schwallsunk/Geiger_Mueller_Handheld/Hardware/CAD/top_case_geiger_counter_slider.step

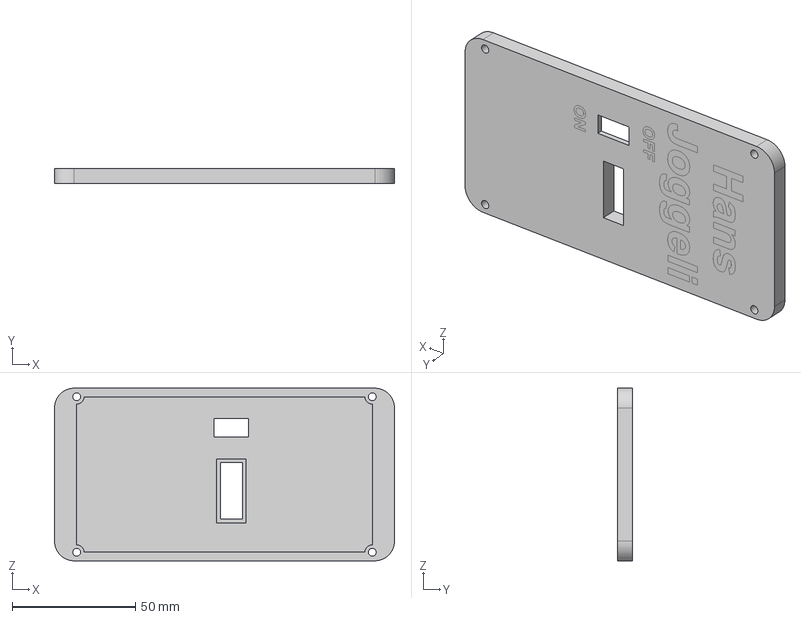
[picture p1: CAD file, 2026-09-18]
Hardware/CAD/top_case_geiger_counter_slider.step
138.0 x 6.00 x 70.1 mm
