schwallsunk/Geiger_Mueller_Handheld/Hardware/EDA/Geiger_counter_LoRaWAN.step

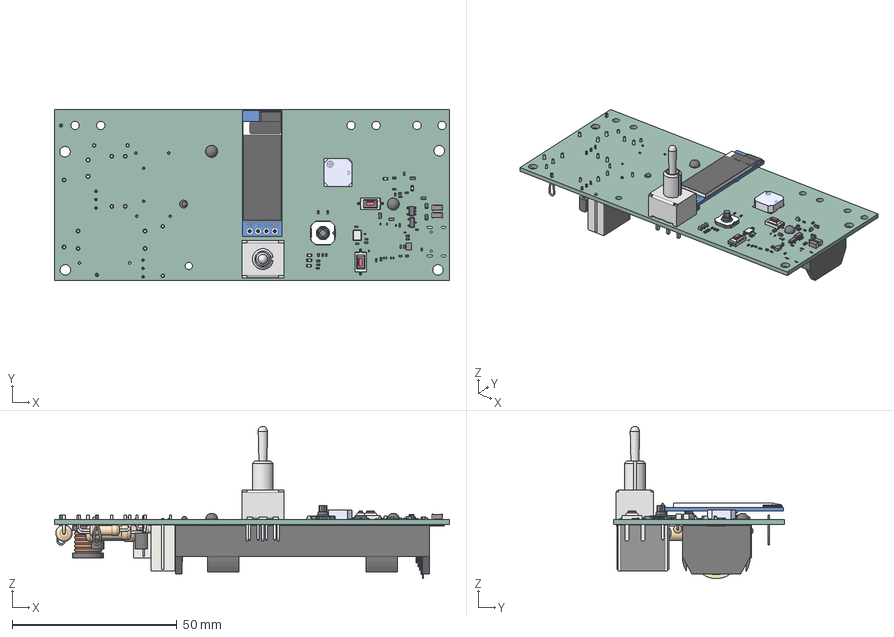
[picture p2: CAD file, 2026-09-18]
Hardware/EDA/Geiger_counter_LoRaWAN.step
120.0 x 52.1 x 46.3 mm
C_1206_3216Metric x 2
C_0402_1005Metric x 7
R_0402_1005Metric x 23
SW_SPST_CK_RS282G05A3 x 2
C_0603_1608Metric x 4
Crystal_SMD_3225-4Pin_3.2x2.5mm
C_0201_0603Metric x 10
R_0603_1608Metric x 2
LED_0603_1608Metric x 5
SOT-23
SOT-23-5
OLED_0.91_128x32
Pin Header 4 x 1 TH 2.54mm Pitch
RESC-0603 x 13
2SD0601A
SKRHABE010
AOTA-B201610S3R3-101-T
Same_Sky_CMT-8503-36-SMT-TR
P:\E-Switch Secure\3D_MODELS_STP_FORMAT\100DPxT1B1M2xE.stp
R_Axial_DIN0516_L155mm_D50mm_P2032mm_Horizontal x 2
R_Axial_DIN0411_L99mm_D36mm_P1524mm_Horizontal x 2
TO-92_Inline_Wide x 2
L_Radial_D9.5mm_P5.00mm_Fastron_07HVP
C_Rect_L110mm_W63mm_P1000mm_MKT x 2
D_DO-41_SOD81_P10.16mm_Horizontal
R_Axial_DIN0207_L63mm_D25mm_P1016mm_Horizontal
TestPoint_Loop_D2.50mm_Drill1.0mm x 2
R_Axial_DIN0309_L90mm_D32mm_P1524mm_Horizontal
R_Axial_DIN0414_L119mm_D45mm_P2032mm_Horizontal
Keystone_1042_1x18650
C_Rect_L165mm_W73mm_P1500mm_MKT
GeiA07C_PCB
