schwallsunk/Geiger_Mueller_Handheld/Hardware/CAD/bottom_case_geiger_mobile.step

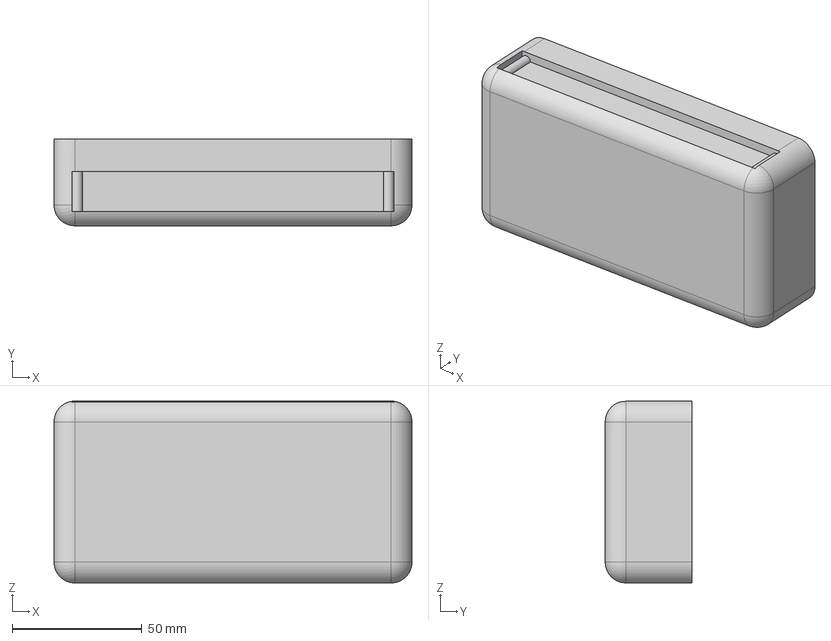
[picture p3: CAD file, 2026-09-18]
Hardware/CAD/bottom_case_geiger_mobile.step
138.0 x 33.4 x 70.1 mm
