schwallsunk/Geiger_Mueller_Handheld/Hardware/EDA/Schematic_Geiger_handheld.pdf

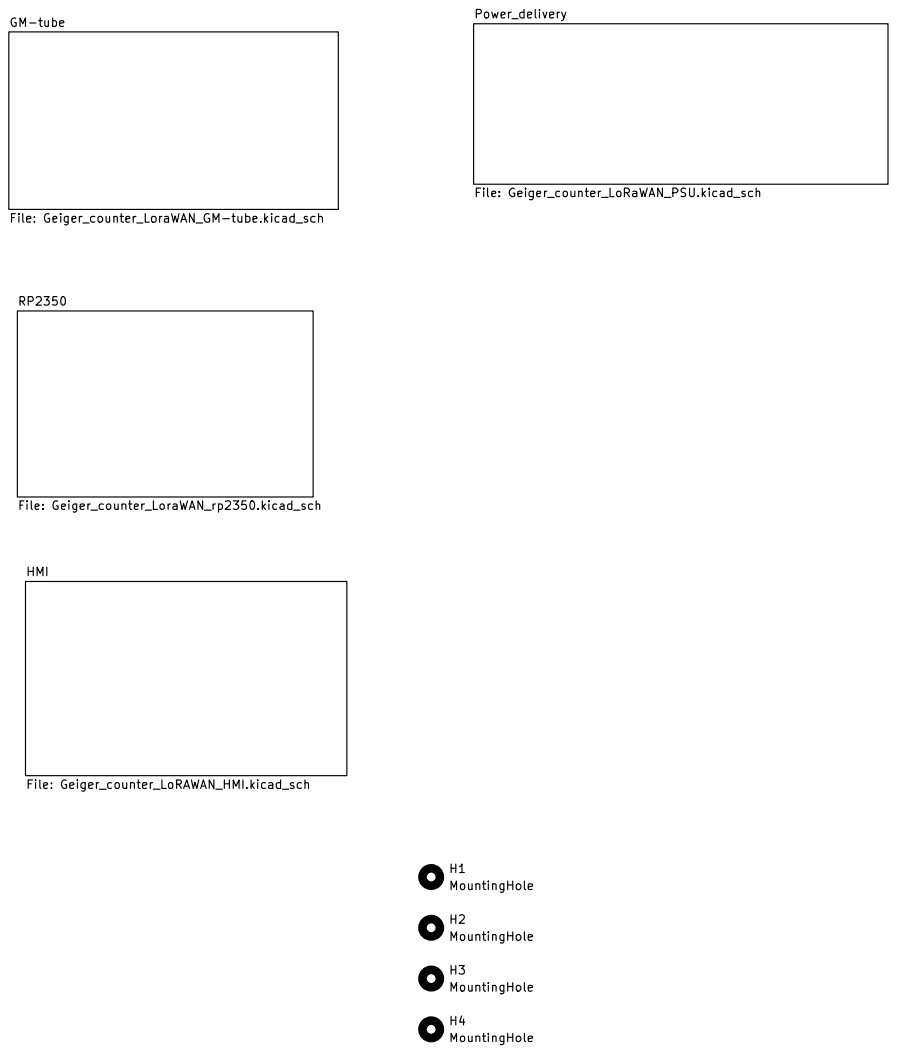
[picture p4: page 1]

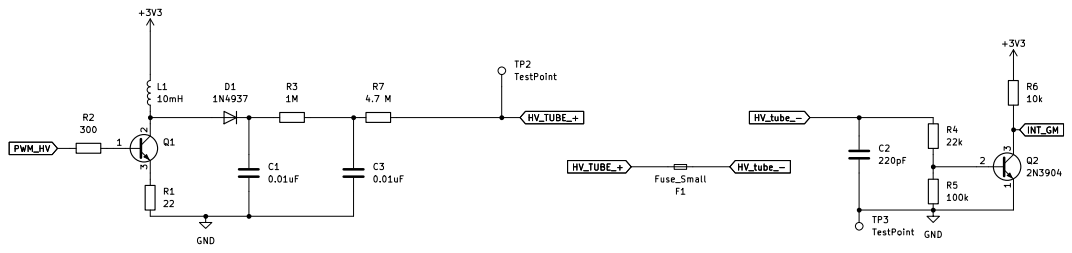
[picture p5: page 2]

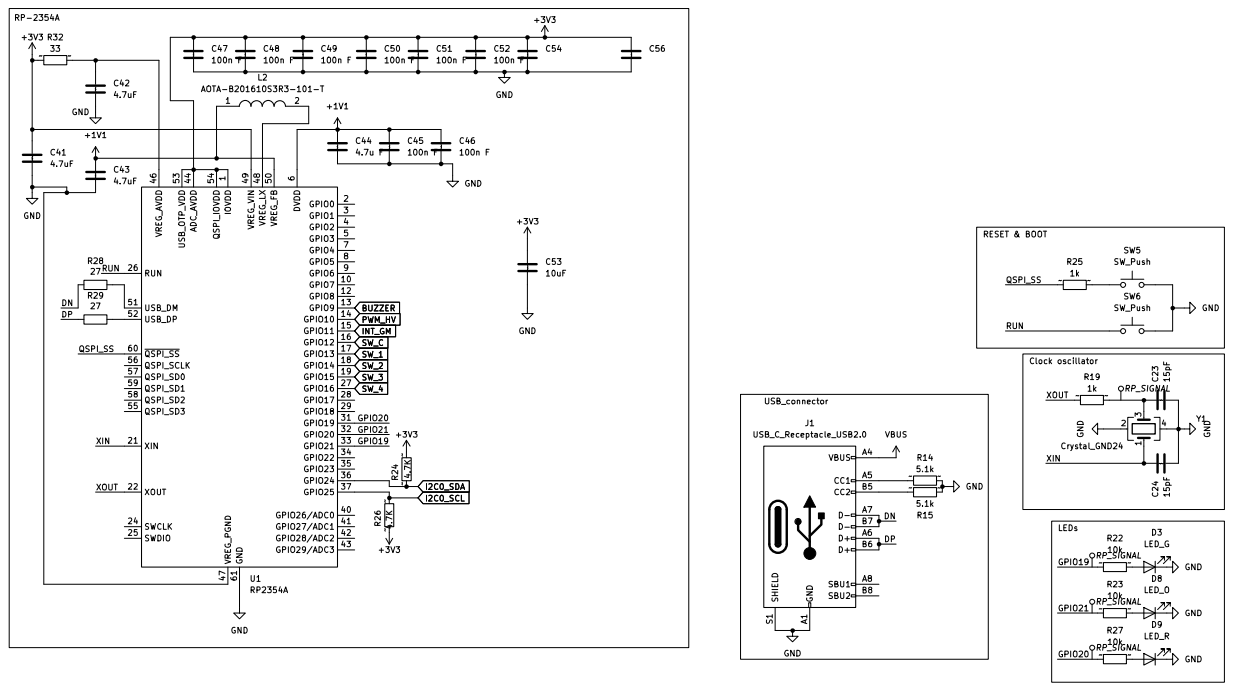
[picture p6: page 3]

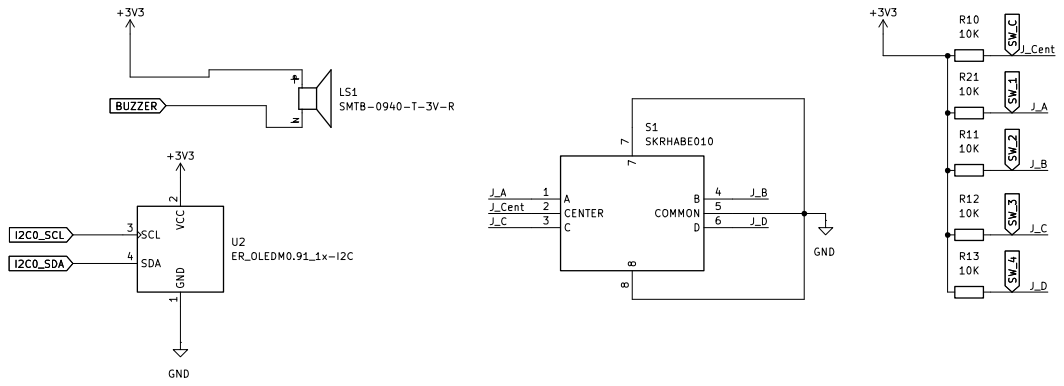
[picture p7: page 4]

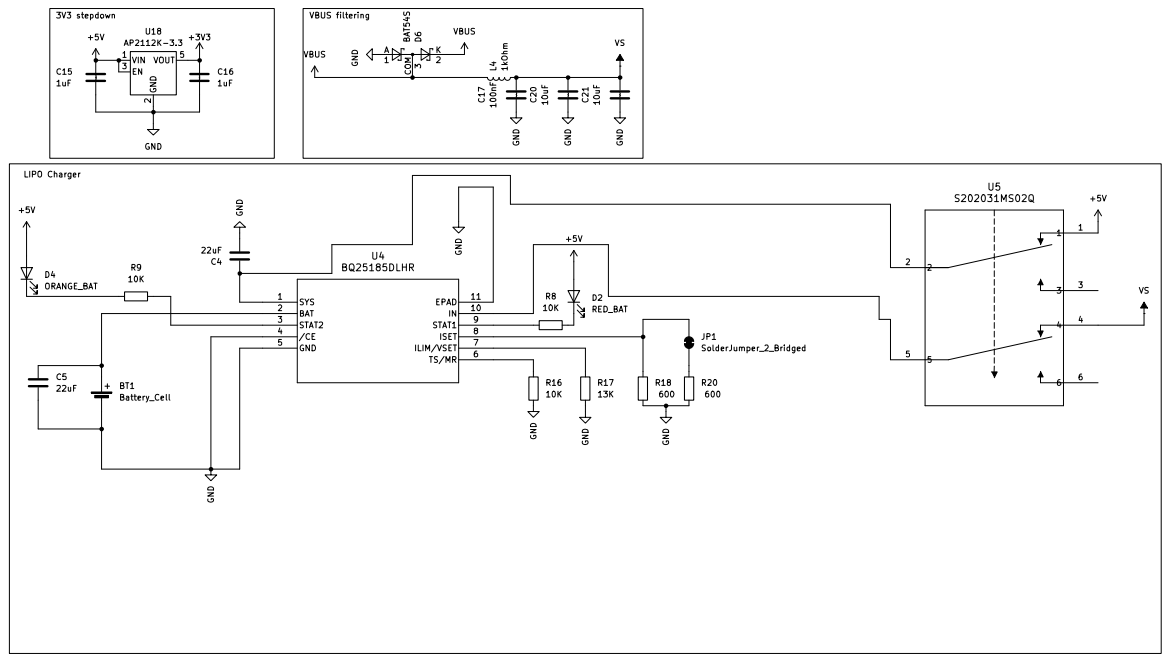
[picture p8: page 5]
