schwallsunk/Geiger_Mueller_Handheld/Hardware/EDA/Geiger_counter_LoRaWAN.kicad_pcb

## KiCad design Hardware/EDA/Geiger_counter_LoRaWAN.kicad_pcb (2026-09-18)

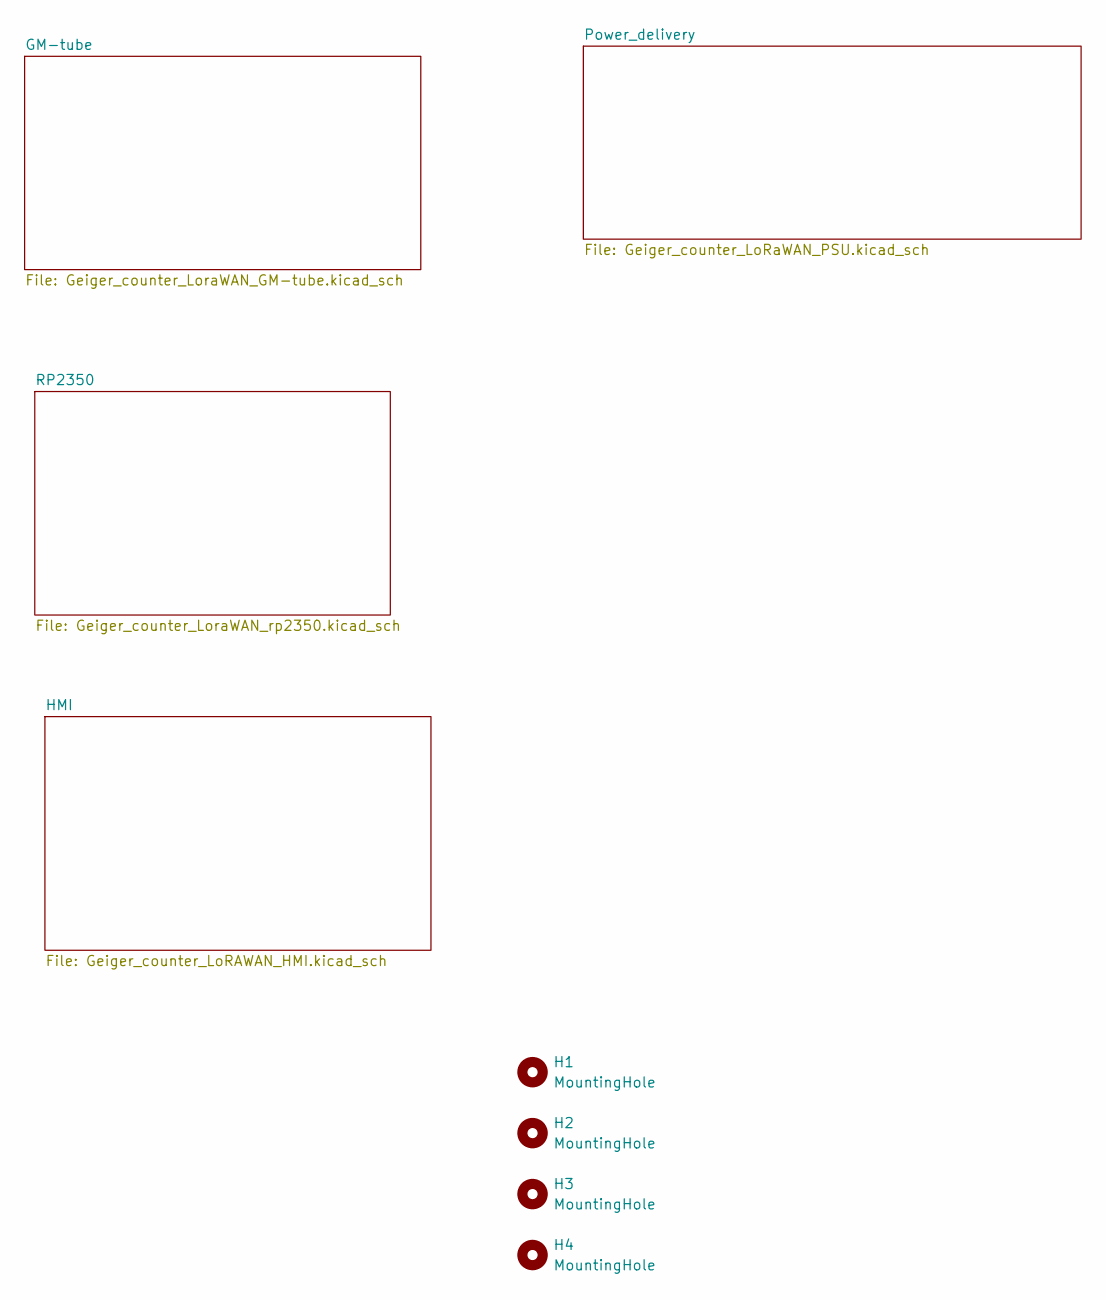
[picture p9: schematic Geiger_counter_LoRaWAN.kicad_sch]

Parts:
H1, H2, H3, H4: MountingHole; MountingHole_3.2mm_M3_ISO14580

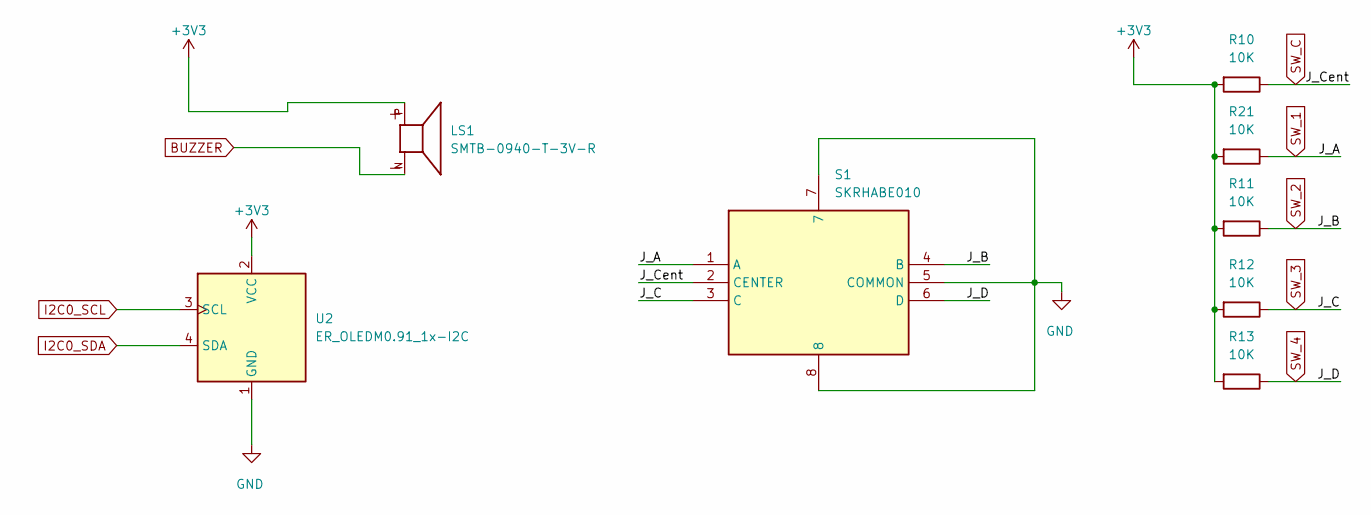
[picture p10: schematic Geiger_counter_LoRAWAN_HMI.kicad_sch]

Parts:
LS1: SMTB-0940-T-3V-R; XDCR_SMTB-0940-T-3V-R; PARTREV 01/24/2017
R10, R11, R12, R13, R21: 10K; R_0402_1005Metric
S1: SKRHABE010; Manufacturer_Part_Number SKRHABE010; Mouser Part Number 688-SKRHAB
U2: ER_OLEDM0.91_1x-I2C

Connections:
+3V3: LS1.P, R10.2, R11.2, R12.2, R13.2, R21.2, U2.2 (VCC); also elsewhere on the board
BUZZER: LS1.N; also elsewhere on the board
GND: S1.5 (COMMON), S1.7, S1.8, U2.1 (GND); also elsewhere on the board
I2C0_SCL: U2.3 (SCL); also elsewhere on the board
I2C0_SDA: U2.4 (SDA); also elsewhere on the board
SW_1: R21.1, S1.1 (A); also elsewhere on the board
SW_2: R11.1, S1.4 (B); also elsewhere on the board
SW_3: R12.1, S1.3 (C); also elsewhere on the board
SW_4: R13.1, S1.6 (D); also elsewhere on the board
SW_C: R10.1, S1.2 (CENTER); also elsewhere on the board

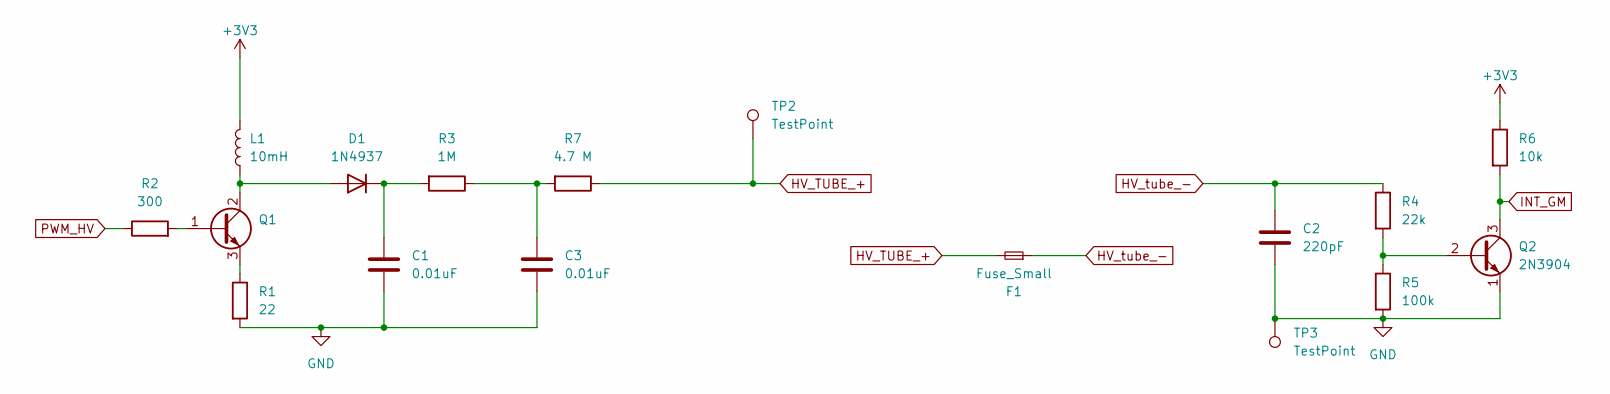
[picture p11: schematic Geiger_counter_LoraWAN_GM-tube.kicad_sch]

Parts:
C1, C3: 0.01uF; C_Rect_L11.0mm_W6.3mm_P10.00mm_MKT
C2: 220pF; C_Rect_L16.5mm_W7.3mm_P15.00mm_MKT
D1: 1N4937; D_DO-41_SOD81_P10.16mm_Horizontal
F1: Fuse_Small; SBM-20_GM_holder
L1: 10mH; L_Radial_D9.5mm_P5.00mm_Fastron_07HVP
Q1: MJE13003; TO-92_Inline_Wide
Q2: 2N3904; TO-92_Inline_Wide
R1: 22; R_Axial_DIN0516_L15.5mm_D5.0mm_P20.32mm_Horizontal
R2: 300; R_Axial_DIN0207_L6.3mm_D2.5mm_P10.16mm_Horizontal
R3: 1M; R_Axial_DIN0411_L9.9mm_D3.6mm_P15.24mm_Horizontal
R4: 22k; R_Axial_DIN0516_L15.5mm_D5.0mm_P20.32mm_Horizontal
R5: 100k; R_Axial_DIN0414_L11.9mm_D4.5mm_P20.32mm_Horizontal
R6: 10k; R_Axial_DIN0309_L9.0mm_D3.2mm_P15.24mm_Horizontal
R7: 4.7 M; R_Axial_DIN0411_L9.9mm_D3.6mm_P15.24mm_Horizontal
TP2, TP3: TestPoint; TestPoint_Loop_D2.50mm_Drill1.0mm

Connections:
+3V3: L1.2, R6.1; also elsewhere on the board
GND: C1.2, C2.2, C3.2, Q2.1 (E), R1.2, R5.2, TP3.1 (1_1); also elsewhere on the board
HV_TUBE_+: F1.2, R7.1, TP2.1 (1_1)
HV_tube_-: C2.1, F1.1, R4.1
INT_GM: Q2.3 (C), R6.2; also elsewhere on the board
unnamed: C3.1, R3.1, R7.2
unnamed: D1.2 (A), L1.1, Q1.2 (C)
unnamed: C1.1, D1.1 (K), R3.2
unnamed: Q1.1 (B), R2.2
unnamed: Q1.3 (E), R1.1
unnamed: Q2.2 (B), R4.2, R5.1
PWM_HV: R2.1; also elsewhere on the board

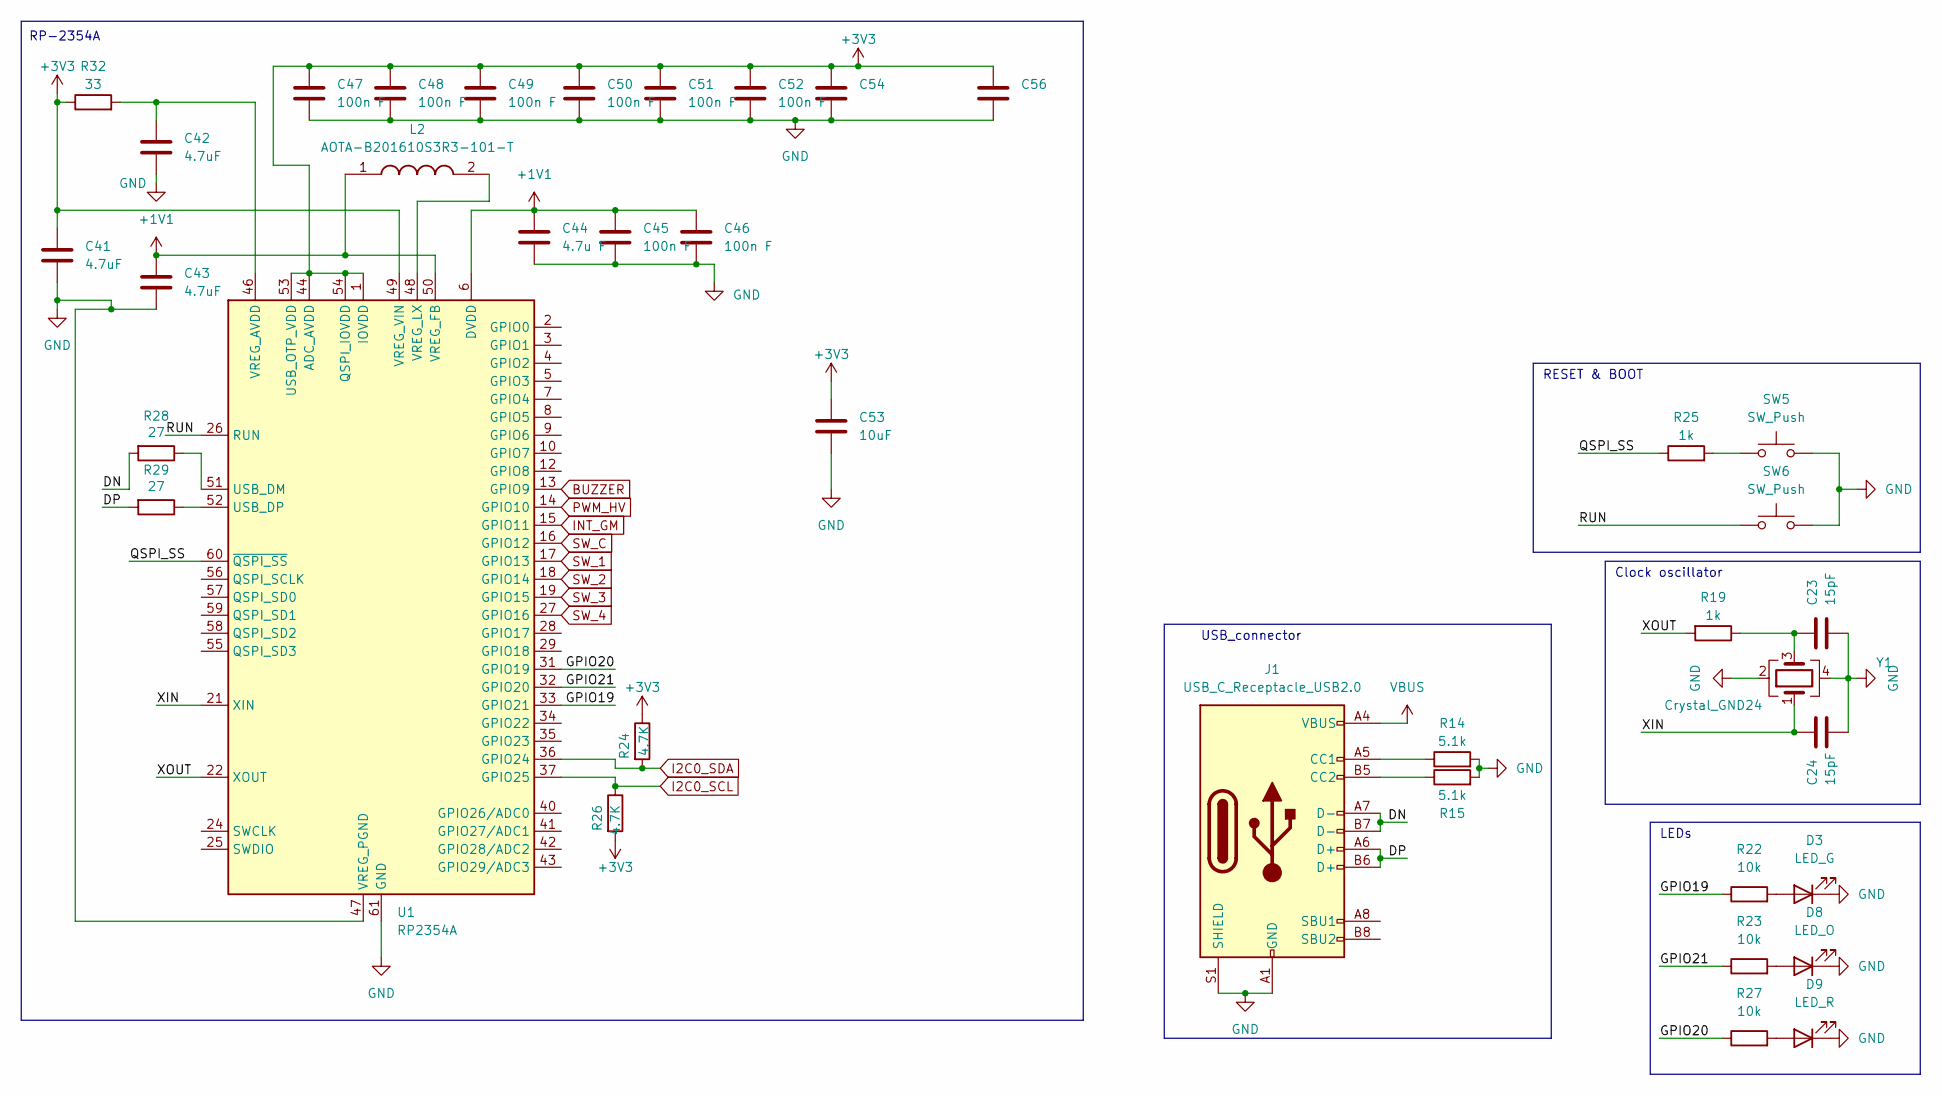
[picture p12: schematic Geiger_counter_LoraWAN_rp2350.kicad_sch]

Parts:
C23, C24: 15pF; C_0402_1005Metric_Pad0.74x0.62mm_HandSolder
C41, C42, C43: 4.7uF; C_0402_1005Metric
C44: 4.7u F; C_0402_1005Metric
C45, C46, C47, C48, C49, C50, C51, C52, C54, C56: 100n F; C_0201_0603Metric
C53: 10uF; C_0603_1608Metric
D3: LED_G; LED_0603_1608Metric_Pad1.05x0.95mm_HandSolder
D8: LED_O; LED_0603_1608Metric_Pad1.05x0.95mm_HandSolder
D9: LED_R; LED_0603_1608Metric_Pad1.05x0.95mm_HandSolder
J1: USB_C_Receptacle_USB2.0; USB_C_Receptacle_G-Switch_GT-USB-7010ASV
L2: AOTA-B201610S3R3-101-T; AOTAB201610S3R3101T; Manufacturer_Part_Number AOTA-B201610S3R3-101-T; Mouser Part Number 815-AB201610S3R3101T
R14, R15: 5.1k; R_0402_1005Metric_Pad0.72x0.64mm_HandSolder
R19, R25: 1k; R_0402_1005Metric_Pad0.72x0.64mm_HandSolder
R22, R23, R27: 10k; R_0402_1005Metric
R24, R26: 4.7K; R_0402_1005Metric_Pad0.72x0.64mm_HandSolder
R28, R29: 27; R_0402_1005Metric
R32: 33; R_0402_1005Metric_Pad0.72x0.64mm_HandSolder
SW5, SW6: SW_Push; SW_SPST_CK_RS282G05A3
U1: RP2354A; QFN-60-1EP_7x7mm_P0.4mm_EP3.4x3.4mm
Y1: Crystal_GND24; Crystal_SMD_3225-4Pin_3.2x2.5mm

Connections:
+1V1: C43.1, C44.1, C45.1, C46.1, L2.1, U1.6 (DVDD), U1.23 (DVDD), U1.39 (DVDD), U1.50 (VREG_FB)
+3V3: C41.1, C47.1, C48.1, C49.1, C50.1, C51.1, C52.1, C53.2, C54.1, C56.1, R24.1, R26.2, R32.1, U1.1 (IOVDD), U1.11 (IOVDD), U1.20 (IOVDD), U1.30 (IOVDD), U1.38 (IOVDD), U1.44 (ADC_AVDD), U1.45 (IOVDD), U1.49 (VREG_VIN), U1.53 (USB_OTP_VDD), U1.54 (QSPI_IOVDD); also elsewhere on the board
/RP2350/DN: J1.A7 (D-), J1.B7 (D-), R28.2
/RP2350/DP: J1.A6 (D+), J1.B6 (D+), R29.2
/RP2350/GPIO19: R22.1, U1.33 (GPIO21)
/RP2350/GPIO20: R27.1, U1.31 (GPIO19)
/RP2350/GPIO21: R23.1, U1.32 (GPIO20)
/RP2350/QSPI_SS: R25.1, U1.60 (~QSPI_SS)
/RP2350/RUN: SW6.1, U1.26 (RUN)
/RP2350/XIN: C24.1, U1.21 (XIN), Y1.1
/RP2350/XOUT: R19.2, U1.22 (XOUT)
BUZZER: U1.13 (GPIO9); also elsewhere on the board
GND: C23.2, C24.2, C41.2, C42.2, C43.2, C44.2, C45.2, C46.2, C47.2, C48.2, C49.2, C50.2, C51.2, C52.2, C53.1, C54.2, C56.2, D3.1 (K), D8.1 (K), D9.1 (K), J1.A1 (GND), J1.A12 (GND), J1.B1 (GND), J1.B12 (GND), J1.S1 (SHIELD), R14.2, R15.2, SW5.2, SW6.2, U1.47 (VREG_PGND), U1.61 (GND), Y1.2, Y1.4; also elsewhere on the board
I2C0_SCL: R26.1, U1.37 (GPIO25); also elsewhere on the board
I2C0_SDA: R24.2, U1.36 (GPIO24); also elsewhere on the board
INT_GM: U1.15 (GPIO11); also elsewhere on the board
unnamed: C23.1, R19.1, Y1.3
unnamed: D3.2 (A), R22.2
unnamed: D8.2 (A), R23.2
unnamed: D9.2 (A), R27.2
unnamed: J1.A5 (CC1), R14.1
unnamed: J1.B5 (CC2), R15.1
unnamed: R25.2, SW5.1
unnamed: R28.1, U1.51 (USB_DM)
unnamed: R29.1, U1.52 (USB_DP)
unnamed: C42.1, R32.2, U1.46 (VREG_AVDD)
unnamed: L2.2, U1.48 (VREG_LX)
PWM_HV: U1.14 (GPIO10); also elsewhere on the board
SW_1: U1.17 (GPIO13); also elsewhere on the board
SW_2: U1.18 (GPIO14); also elsewhere on the board
SW_3: U1.19 (GPIO15); also elsewhere on the board
SW_4: U1.27 (GPIO16); also elsewhere on the board
SW_C: U1.16 (GPIO12); also elsewhere on the board
VBUS: J1.A4 (VBUS), J1.A9 (VBUS), J1.B4 (VBUS), J1.B9 (VBUS); also elsewhere on the board

Notes on the sheet:
Clock oscillator
RESET & BOOT
RP-2354A
USB_connector
LEDs

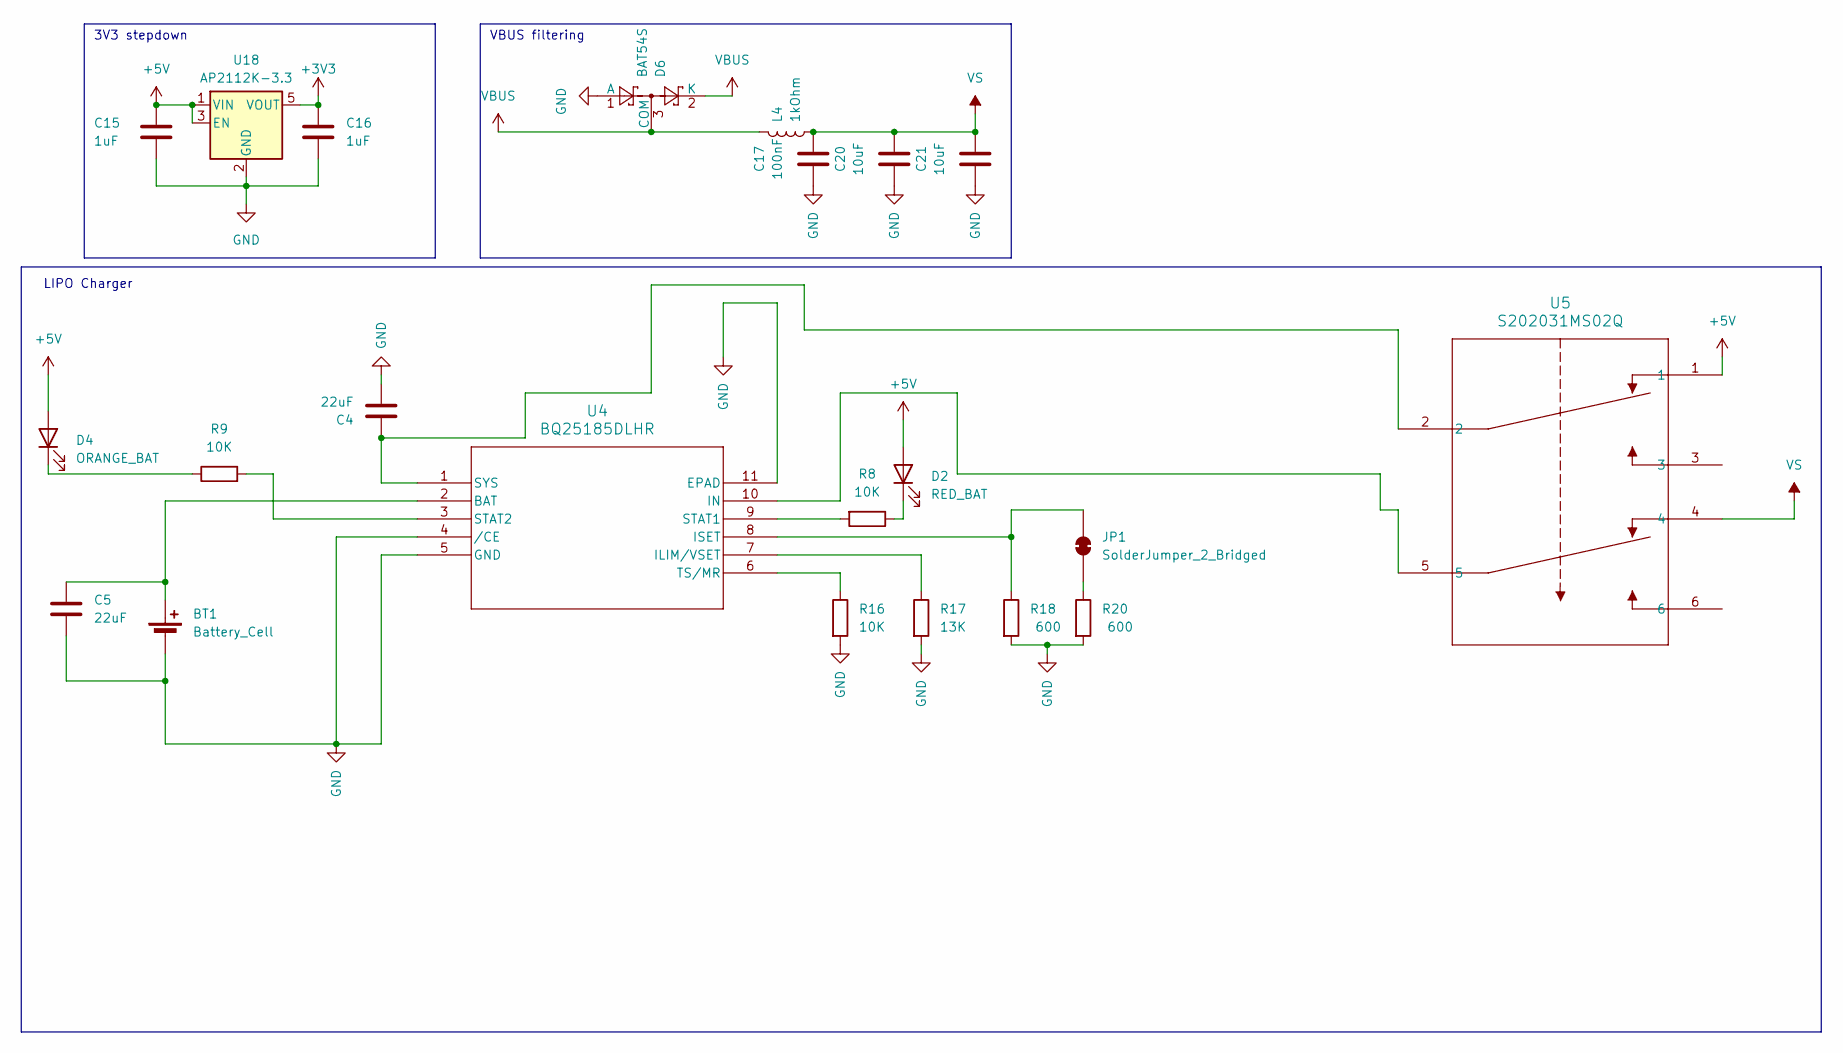
[picture p13: schematic Geiger_counter_LoRaWAN_PSU.kicad_sch]

Parts:
BT1: Battery_Cell; BatteryHolder_Keystone_1042_1x18650
C4: 22uF; C_0603_1608Metric
C5: 22uF; C_0402_1005Metric
C15, C16: 1uF; C_0603_1608Metric_Pad1.08x0.95mm_HandSolder
C17: 100nF; R_0603_1608Metric_Pad0.98x0.95mm_HandSolder
C20, C21: 10uF; C_1206_3216Metric_Pad1.33x1.80mm_HandSolder
D2: RED_BAT; LED_0603_1608Metric_Pad1.05x0.95mm_HandSolder
D4: ORANGE_BAT; LED_0603_1608Metric_Pad1.05x0.95mm_HandSolder
D6: BAT54S; SOT-23
JP1: SolderJumper_2_Bridged; SolderJumper-2_P1.3mm_Open_Pad1.0x1.5mm
L4: 1kOhm; R_0603_1608Metric_Pad0.98x0.95mm_HandSolder
R8, R9, R16: 10K; R_0402_1005Metric
R17: 13K; R_0402_1005Metric
R18, R20: 600; R_0402_1005Metric
U4: BQ25185DLHR; WSON10_DLH_TEX-M
U5: S202031MS02Q; SWITCH_S20203
U18: AP2112K-3.3; SOT-23-5

Connections:
+3V3: C16.1, U18.5 (VOUT); also elsewhere on the board
+5V: C15.1, D2.2 (A), D4.2 (A), U5.1, U18.1 (VIN), U18.3 (EN)
GND: BT1.2 (-), C4.2, C5.2, C15.2, C16.2, C17.2, C20.2, C21.1, D6.1 (A), R16.2, R17.2, R18.2, R20.2, U4.4 (/CE), U4.5 (GND), U4.11 (EPAD), U18.2 (GND); also elsewhere on the board
unnamed: BT1.1 (+), C5.1, U4.2 (BAT)
unnamed: D2.1 (K), R8.1
unnamed: D4.1 (K), R9.1
unnamed: JP1.1 (A), R20.1
unnamed: JP1.2 (B), R18.1, U4.8 (ISET)
unnamed: R17.1, U4.7 (ILIM/VSET)
unnamed: U4.10 (IN), U5.5
unnamed: R8.2, U4.9 (STAT1)
unnamed: R9.2, U4.3 (STAT2)
unnamed: C4.1, U4.1 (SYS), U5.2
unnamed: R16.1, U4.6 (TS/MR)
VBUS: D6.2 (K), D6.3 (COM), L4.2; also elsewhere on the board
VS: C17.1, C20.1, C21.2, L4.1, U5.4

Notes on the sheet:
LIPO Charger
VBUS filtering
3V3 stepdown

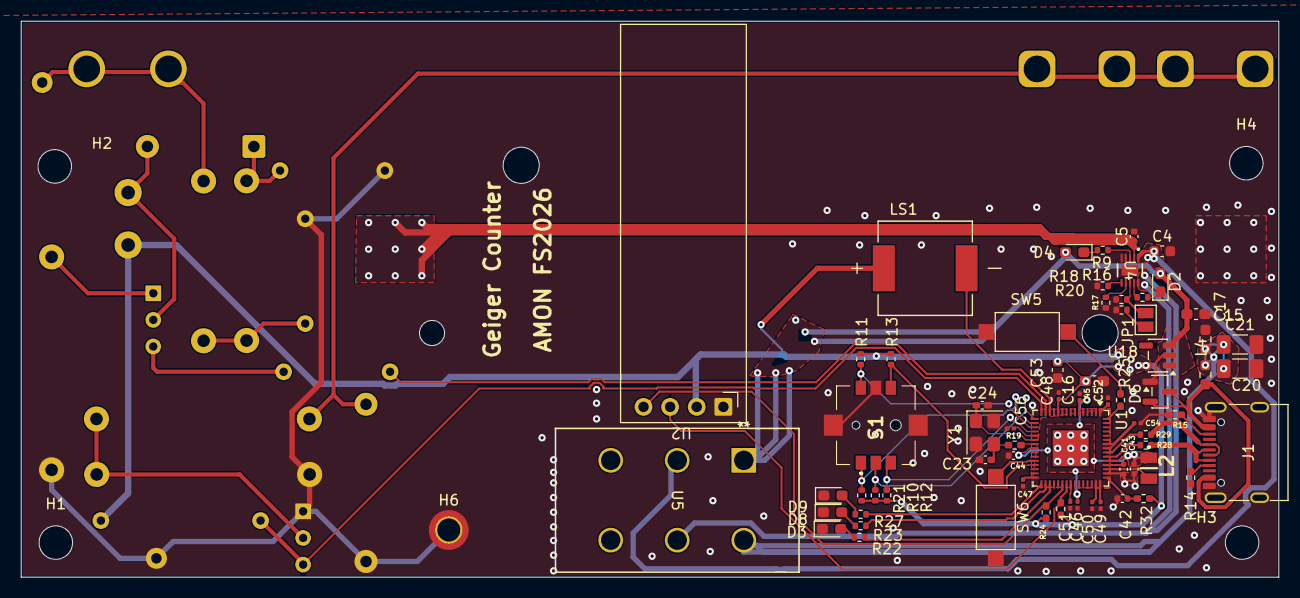
[picture p14: board Geiger_counter_LoRaWAN.kicad_pcb from above]

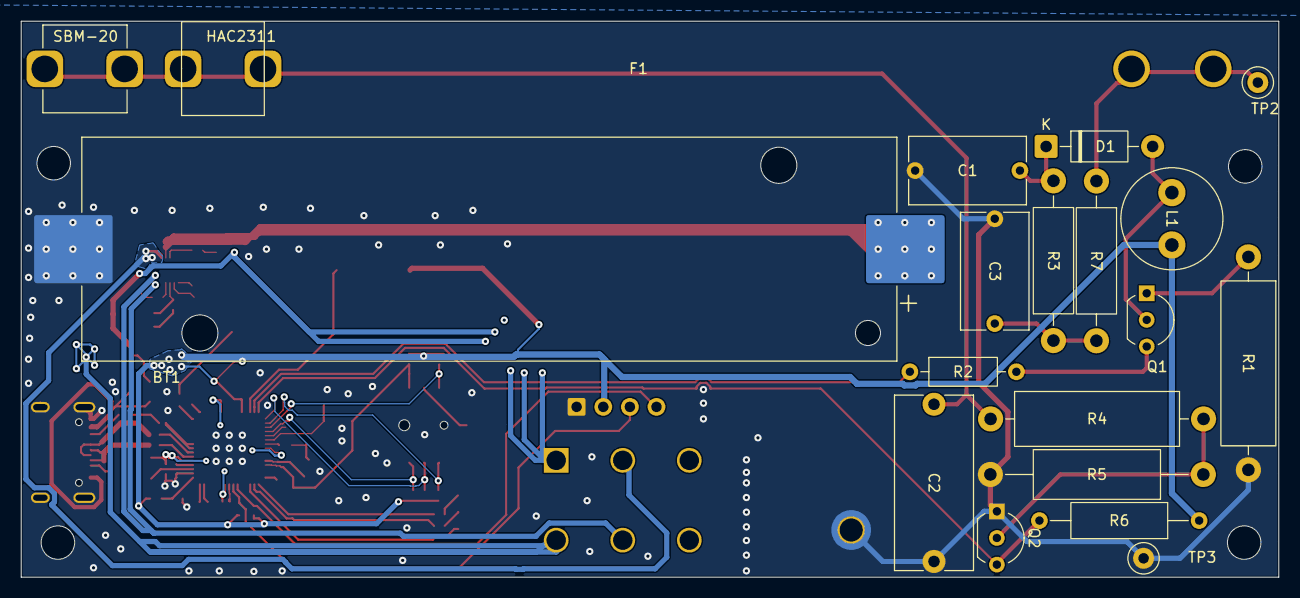
[picture p15: board Geiger_counter_LoRaWAN.kicad_pcb from below]

Board: 2 copper layers, 120.0 x 53.0 mm, 90 parts (18 on the bottom side), 55 nets.

Other parts of the board:
H6: MountingHole_Pad; MountingHole_2.2mm_M2_DIN965_Pad_TopBottom

Their connections:
GND: H6.1 (1_1); also elsewhere on the board
